John-Coding-c/ESP32-C3-WROOM-02-H4/docs/schematics/ESP32IoT-schematic.pdf

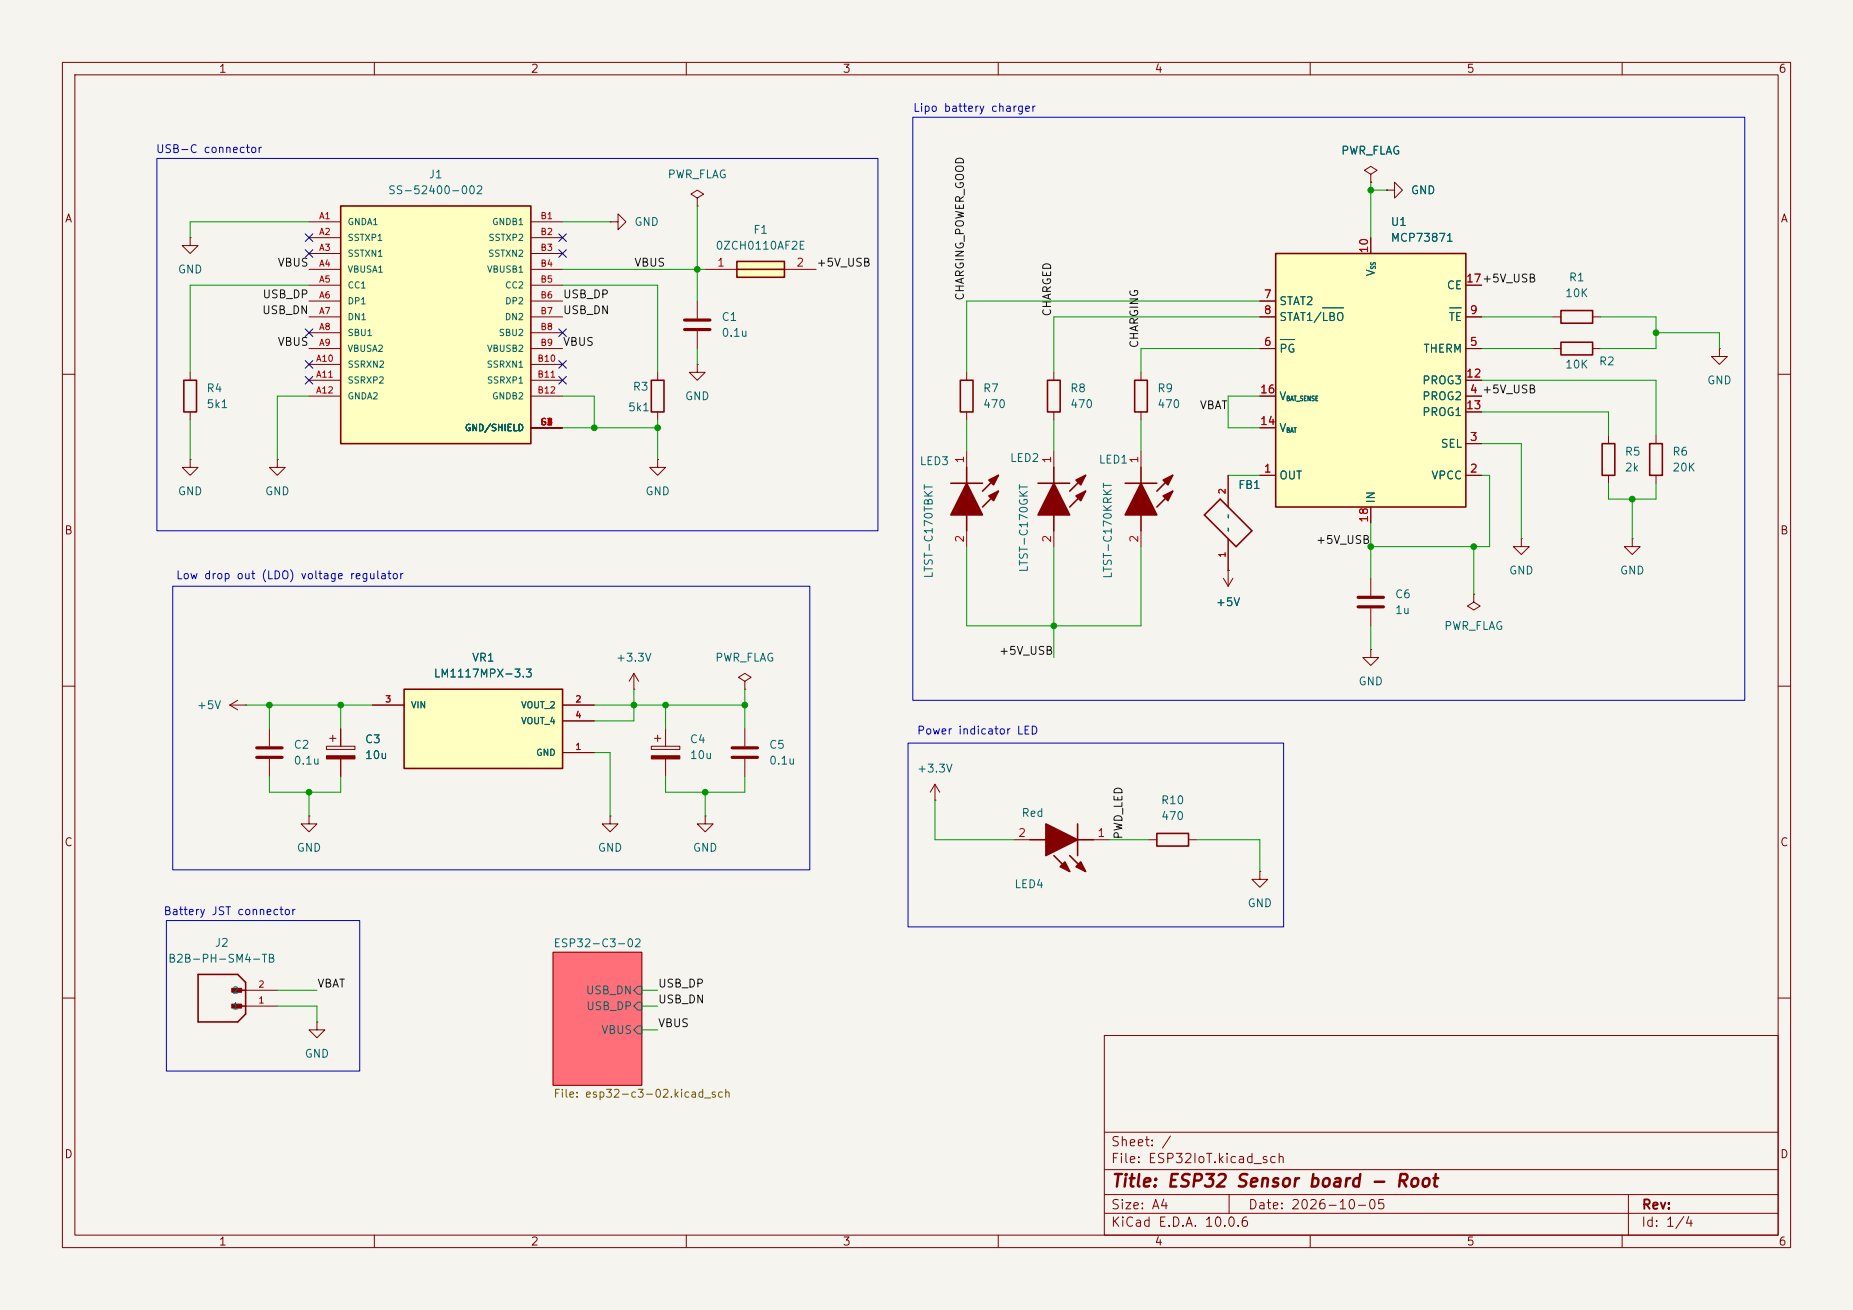
[picture p8: page 1]

Lipo battery charger Low drop out (LDO) voltage regulator

Sheet: /
File: ESP32IoT.kicad_sch
Title: ESP32 Sensor board - Root

Size: A4 | Rev:
KiCad E.D.A. 10.0.6 | Id: 1/4

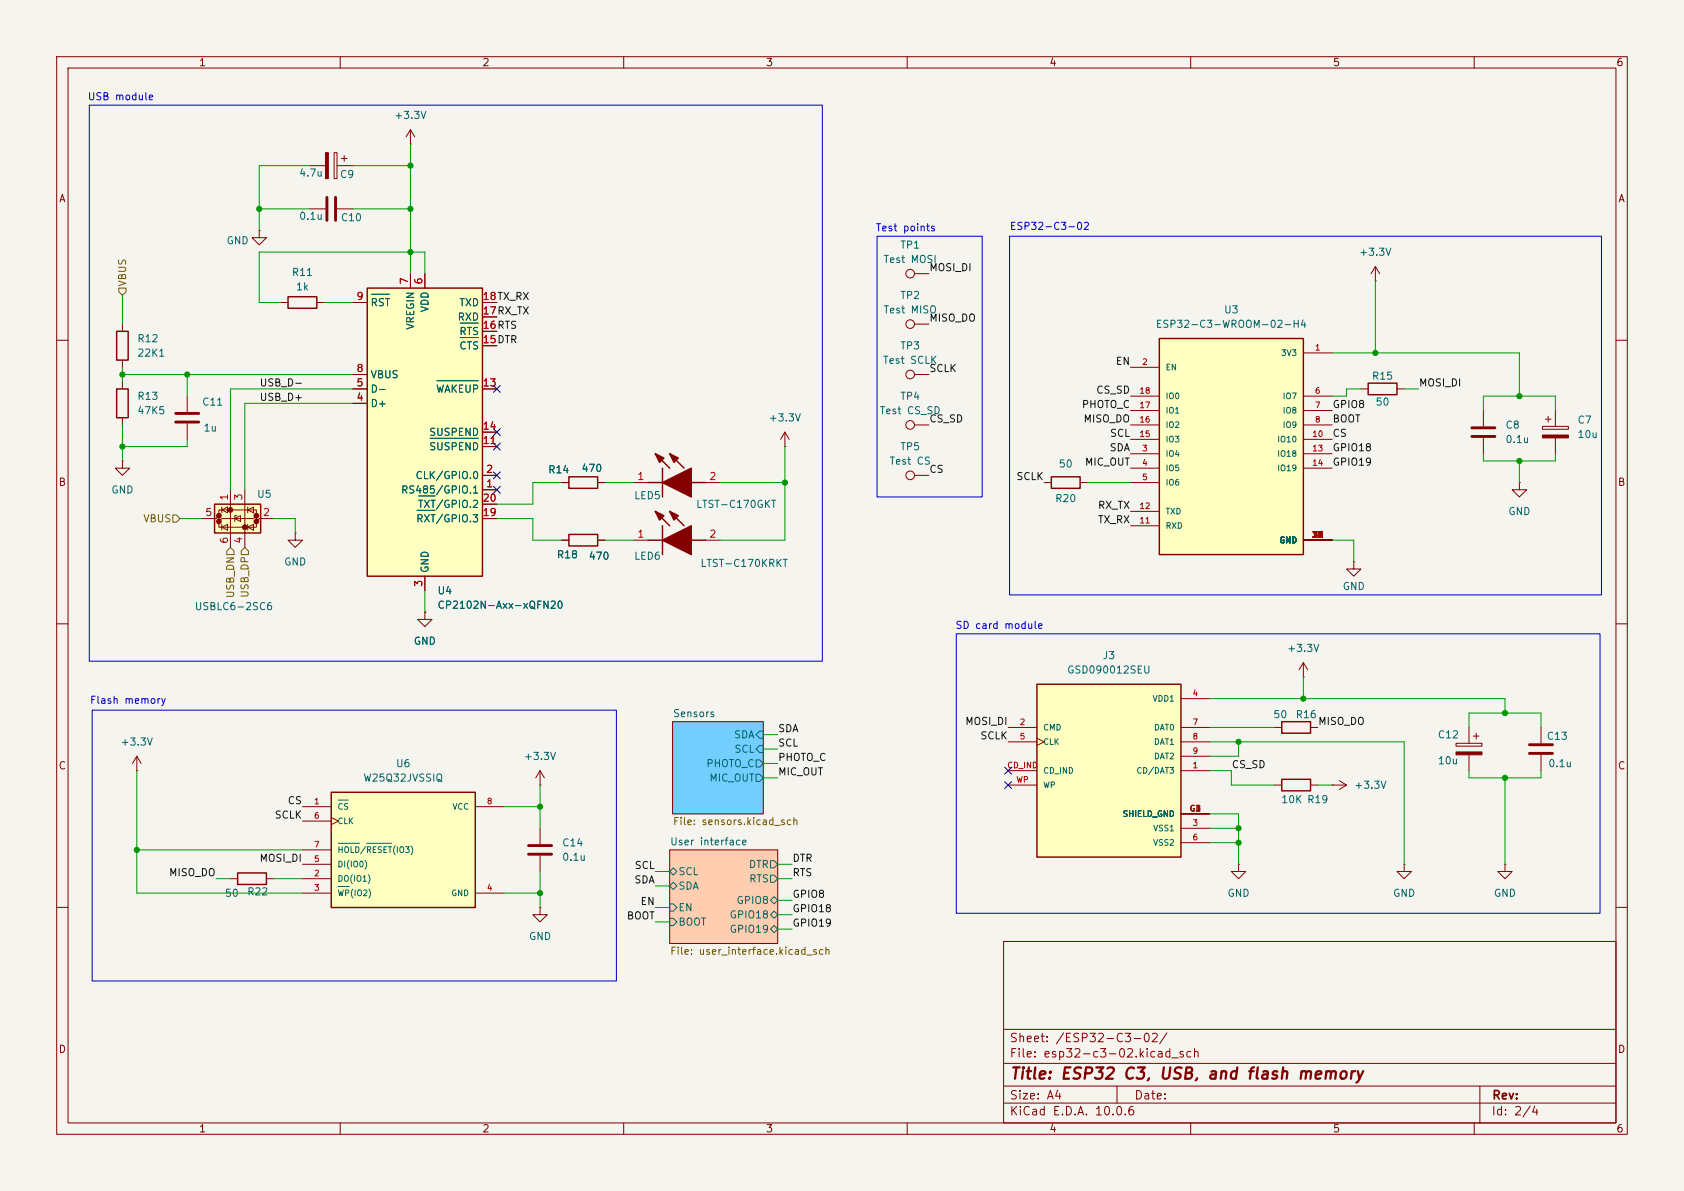
[picture p9: page 2]

SUSPEND 14 CTS 15 RTS 16 RXD 17 TXD 18 RXT/GPIO.3 19 TXT/GPIO.2 20 U4CP2102N-Axx-xQFN20

SCL SDA Sensors File: sensors.kicad_sch

Sheet: /ESP32-C3-02/
File: esp32-c3-02.kicad_sch
Title: ESP32 C3, USB, and flash memory

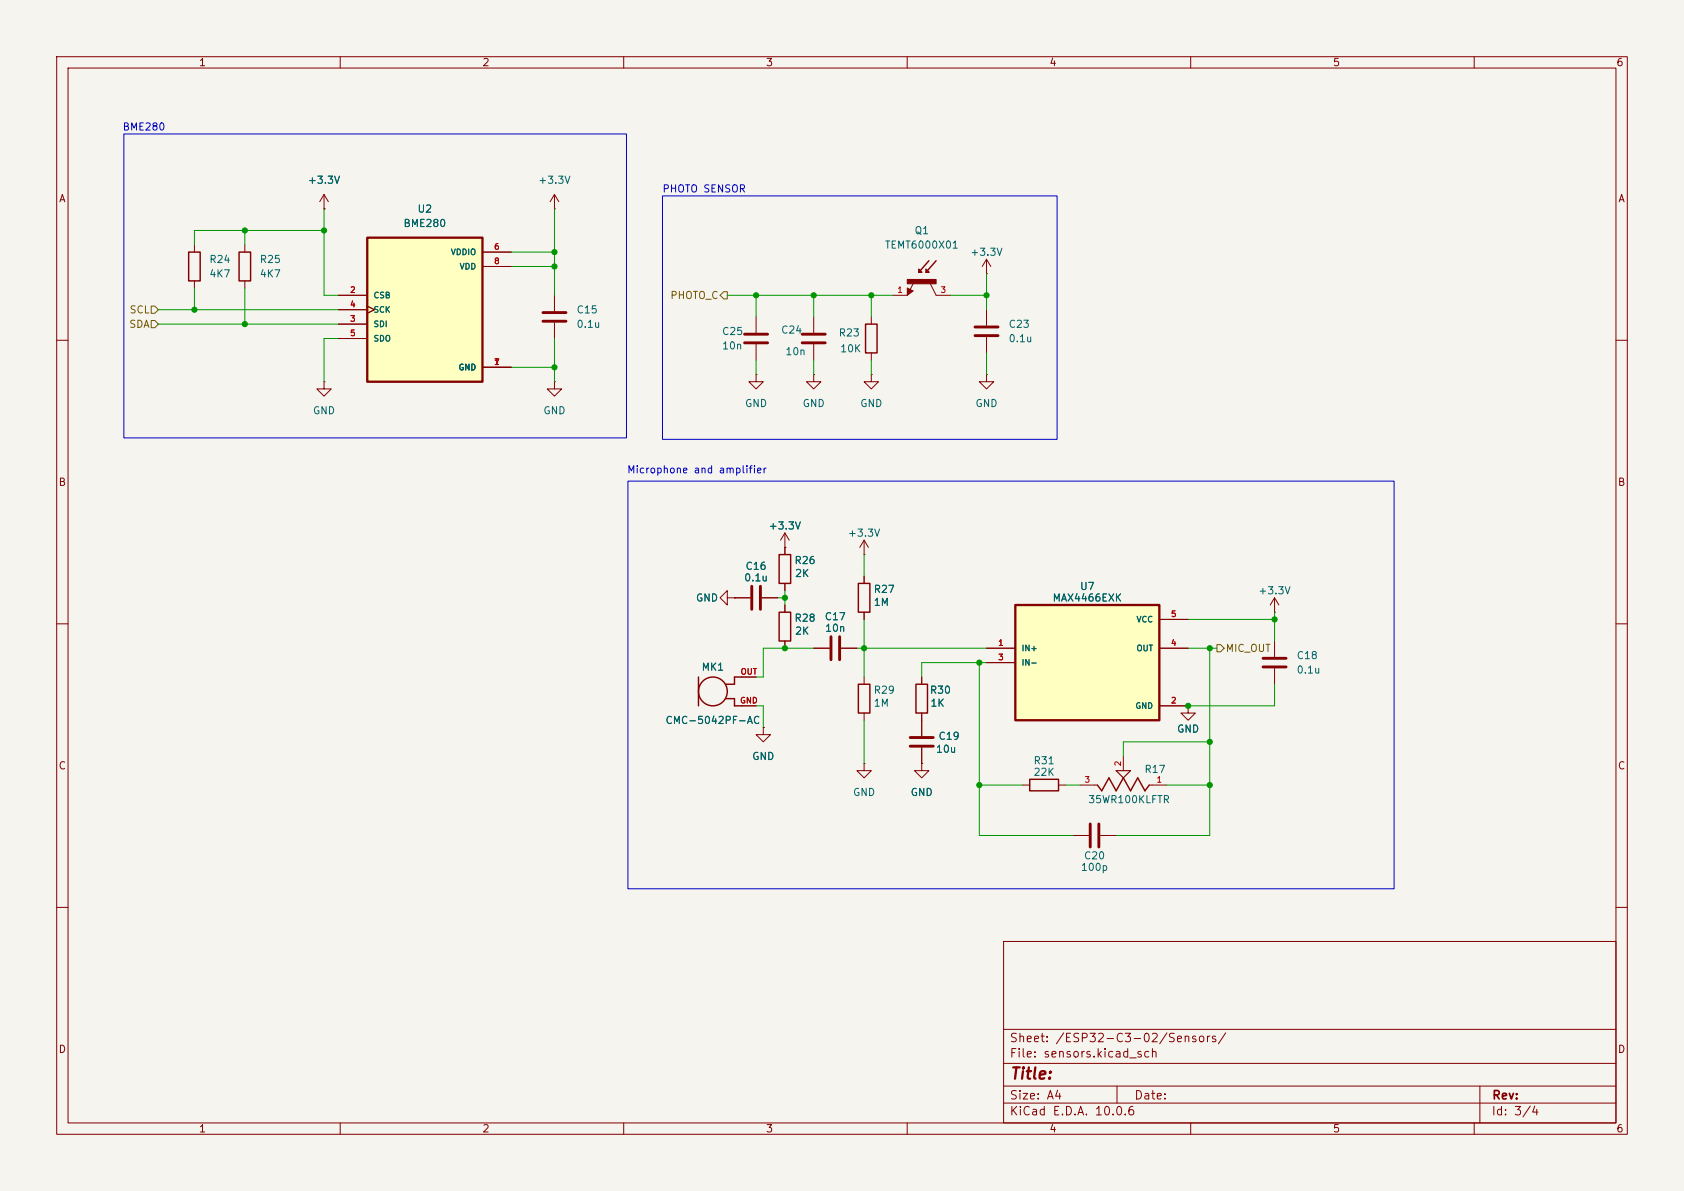
[picture p10: page 3]

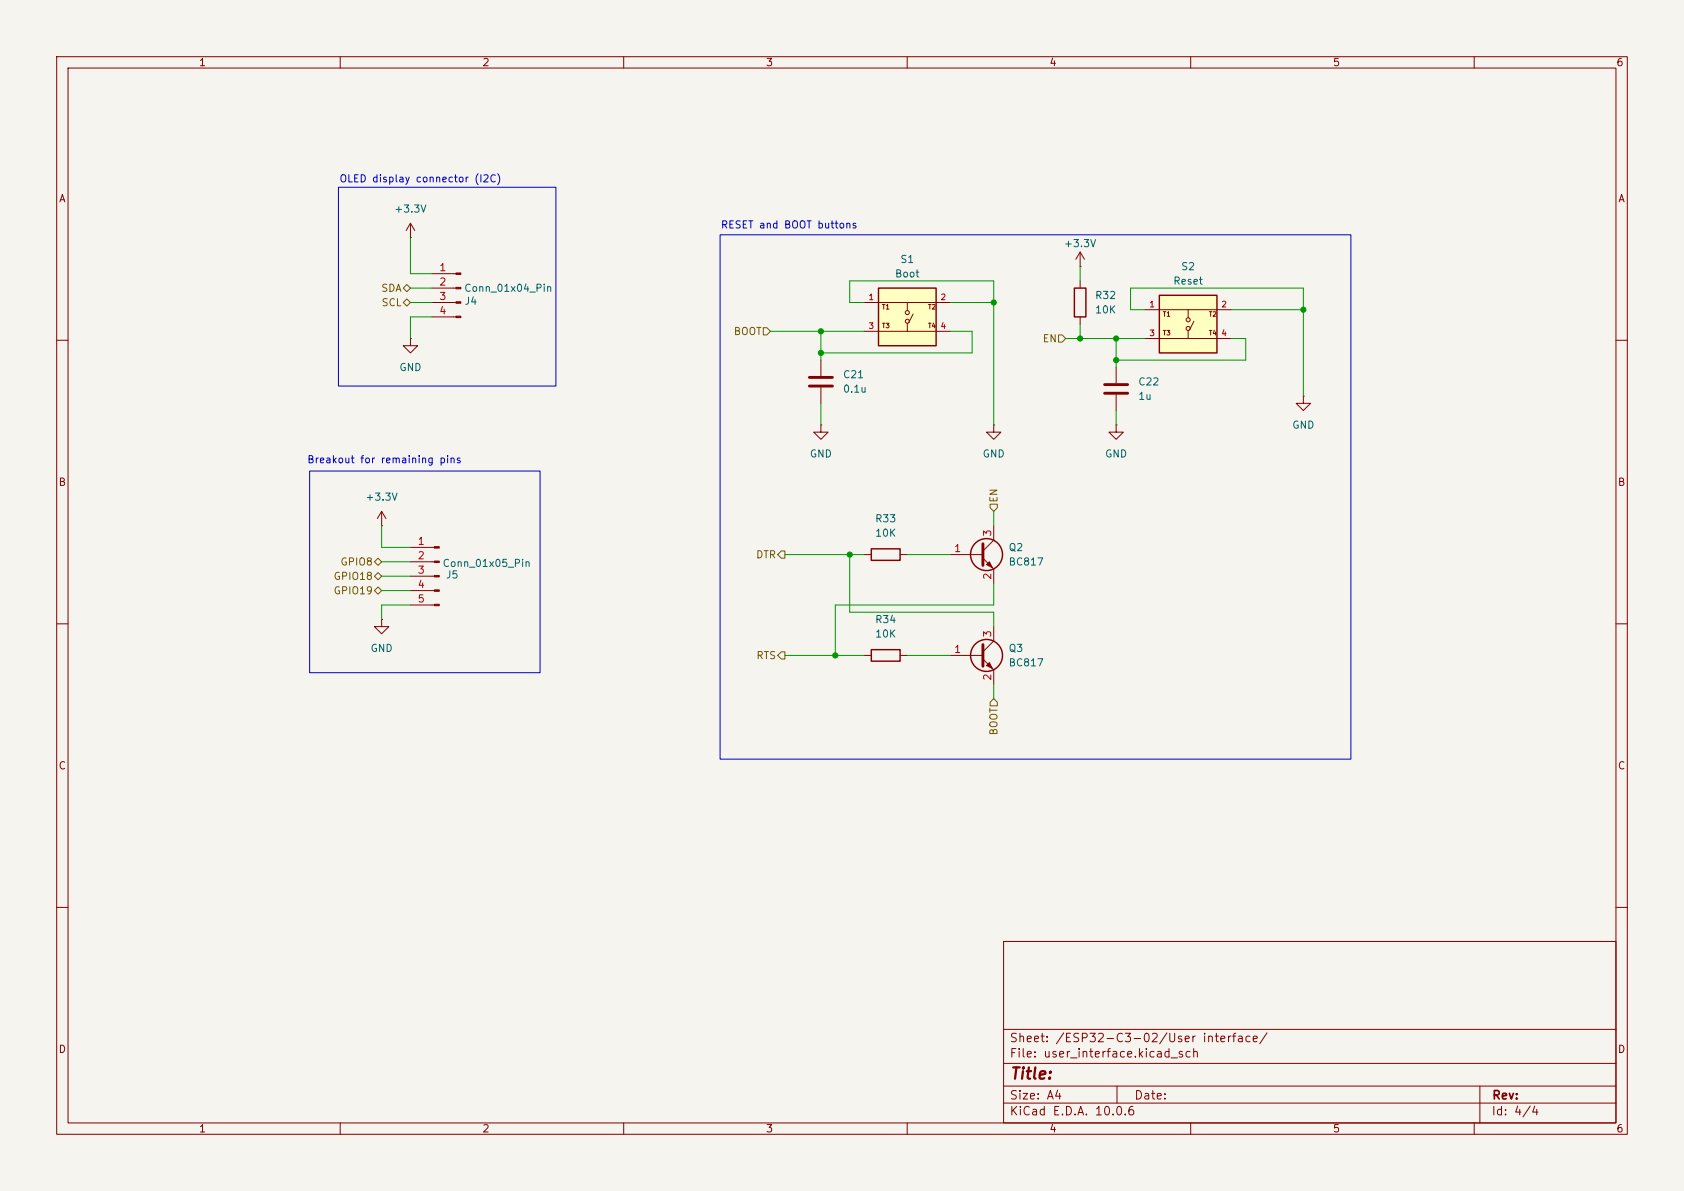
[picture p11: page 4]
