John-Coding-c/ESP32-C3-WROOM-02-H4/ESP32IoT.kicad_pcb

## KiCad design ESP32IoT.kicad_pcb (2026-10-12)

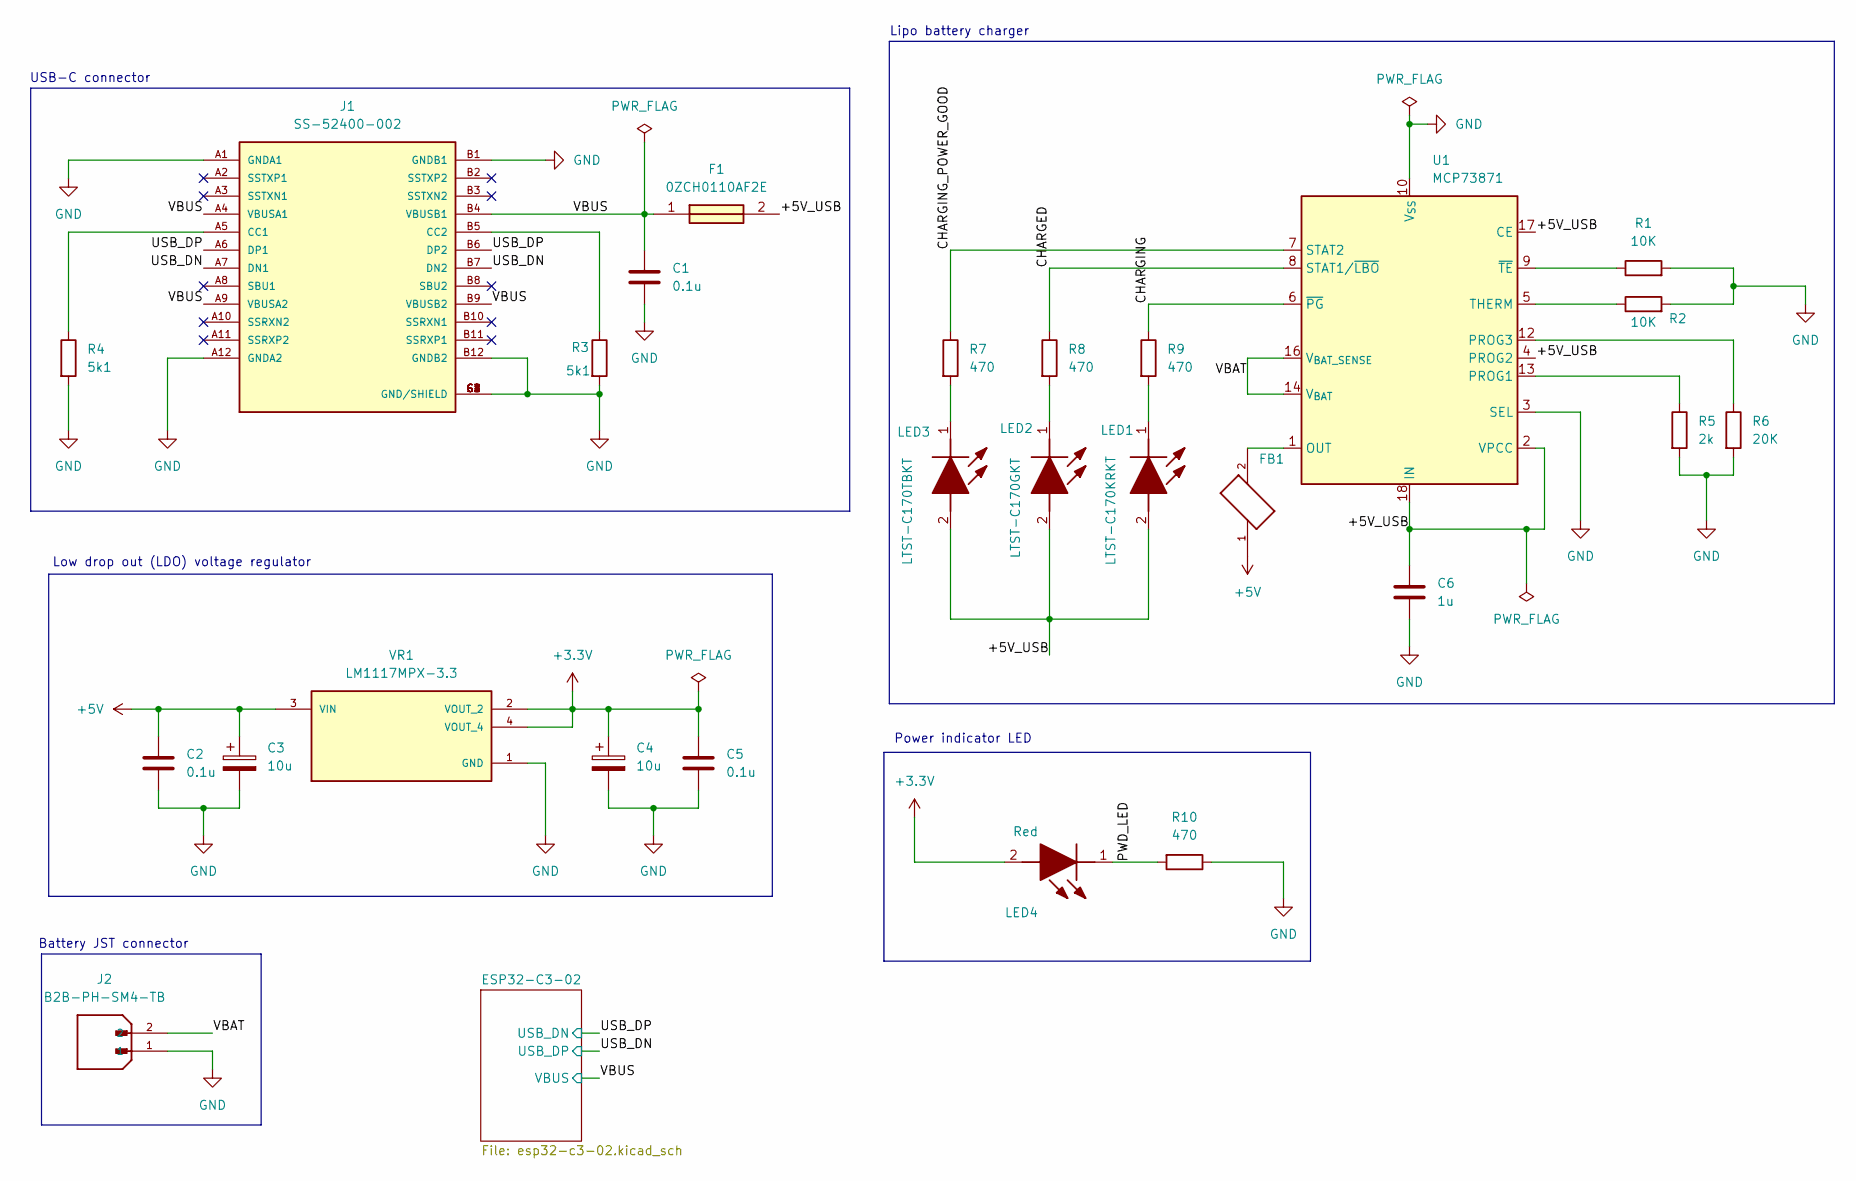
[picture p12: schematic ESP32IoT.kicad_sch, ESP32 Sensor board - Root]

Parts:
C1, C2, C5: 0.1u; C_0805_2012Metric
C3, C4: 10u; T491A
C6: 1u; C_0805_2012Metric
F1: 0ZCH0110AF2E; FUSC3226X100N; Manufacturer_Part_Number 0ZCH0110AF2E
FB1: FBMJ2125HM330-T; BEADC2012X105N
J1: SS-52400-002; BELFUSE_SS-52400-002; PARTREV A0
J2: B2B-PH-SM4-TB; JST_B2B-PH-SM4-TB; PARTREV N/A
LED1: LTST-C170KRKT; LEDC2012X120N; Manufacturer_Part_Number LTST-C170KRKT; Mouser Part Number 859-LTST-C170KRKT
LED2: LTST-C170GKT; LEDC2012X120N; Manufacturer_Part_Number LTST-C170GKT; Mouser Part Number 859-LTST-C170GKT
LED3: LTST-C170TBKT; LEDC2012X120N; Manufacturer_Part_Number LTST-C170TBKT; Mouser Part Number 859-LTST-C170TBKT
LED4: Red; LEDC2012X120N; Manufacturer_Part_Number LTST-C170KRKT; Mouser Part Number 859-LTST-C170KRKT
R1, R2: 10K; R_0805_2012Metric
R3, R4: 5k1; R_0805_2012Metric
R5: 2k; R_0805_2012Metric
R6: 20K; R_0805_2012Metric
R7, R8, R9, R10: 470; R_0805_2012Metric
U1: MCP73871; QFN-20-1EP_4x4mm_P0.5mm_EP2.5x2.5mm
VR1: LM1117MPX-3.3; VREG_LM1117MPX-3.3

Connections:
+3.3V: C4.1, C5.1, LED4.2 (A), VR1.2 (VOUT_2), VR1.4 (VOUT_4); also elsewhere on the board
+5V: C2.1, C3.1, FB1.1, VR1.3 (VIN)
/+5V_USB: C6.1, F1.2, LED1.2 (A), LED2.2 (A), LED3.2 (A), U1.2 (VPCC), U1.4 (PROG2), U1.17 (CE), U1.18 (IN), U1.19 (IN)
/CHARGED: R8.1, U1.8 (STAT1/~LBO)
/CHARGING: R9.1, U1.6 (~PG)
/CHARGING_POWER_GOOD: R7.1, U1.7 (STAT2)
/PWD_LED: LED4.1 (K), R10.2
/USB_DN: J1.A7 (DN1), J1.B7 (DN2); also elsewhere on the board
/USB_DP: J1.A6 (DP1), J1.B6 (DP2); also elsewhere on the board
/VBAT: J2.2, U1.14 (V_{BAT}), U1.15 (V_{BAT}), U1.16 (V_{BAT_SENSE})
/VBUS: C1.1, F1.1, J1.A4 (VBUSA1), J1.A9 (VBUSA2), J1.B4 (VBUSB1), J1.B9 (VBUSB2); also elsewhere on the board
GND: C1.2, C2.2, C3.2, C4.2, C5.2, C6.2, J1.A1 (GNDA1), J1.A12 (GNDA2), J1.B1 (GNDB1), J1.B12 (GNDB2), J1.G1 (GND/SHIELD), J1.G2 (GND/SHIELD), J1.G3 (GND/SHIELD), J1.G4 (GND/SHIELD), J1.S1 (GND/SHIELD), J1.S2 (GND/SHIELD), J1.S3 (GND/SHIELD), J1.S4 (GND/SHIELD), J2.1, R1.2, R2.2, R3.2, R4.2, R5.2, R6.2, R10.1, U1.3 (SEL), U1.10 (V_{SS}), U1.11 (V_{SS}), U1.21 (V_{SS}), VR1.1 (GND); also elsewhere on the board
unnamed: FB1.2, U1.1 (OUT), U1.20 (OUT)
unnamed: J1.A5 (CC1), R4.1
unnamed: J1.B5 (CC2), R3.1
unnamed: LED1.1 (K), R9.2
unnamed: LED2.1 (K), R8.2
unnamed: LED3.1 (K), R7.2
unnamed: R5.1, U1.13 (PROG1)
unnamed: R6.1, U1.12 (PROG3)
unnamed: R2.1, U1.5 (THERM)
unnamed: R1.1, U1.9 (~TE)

Notes on the sheet:
USB-C connector
Power indicator LED
Lipo battery charger
Battery JST connector
Low drop out (LDO) voltage regulator

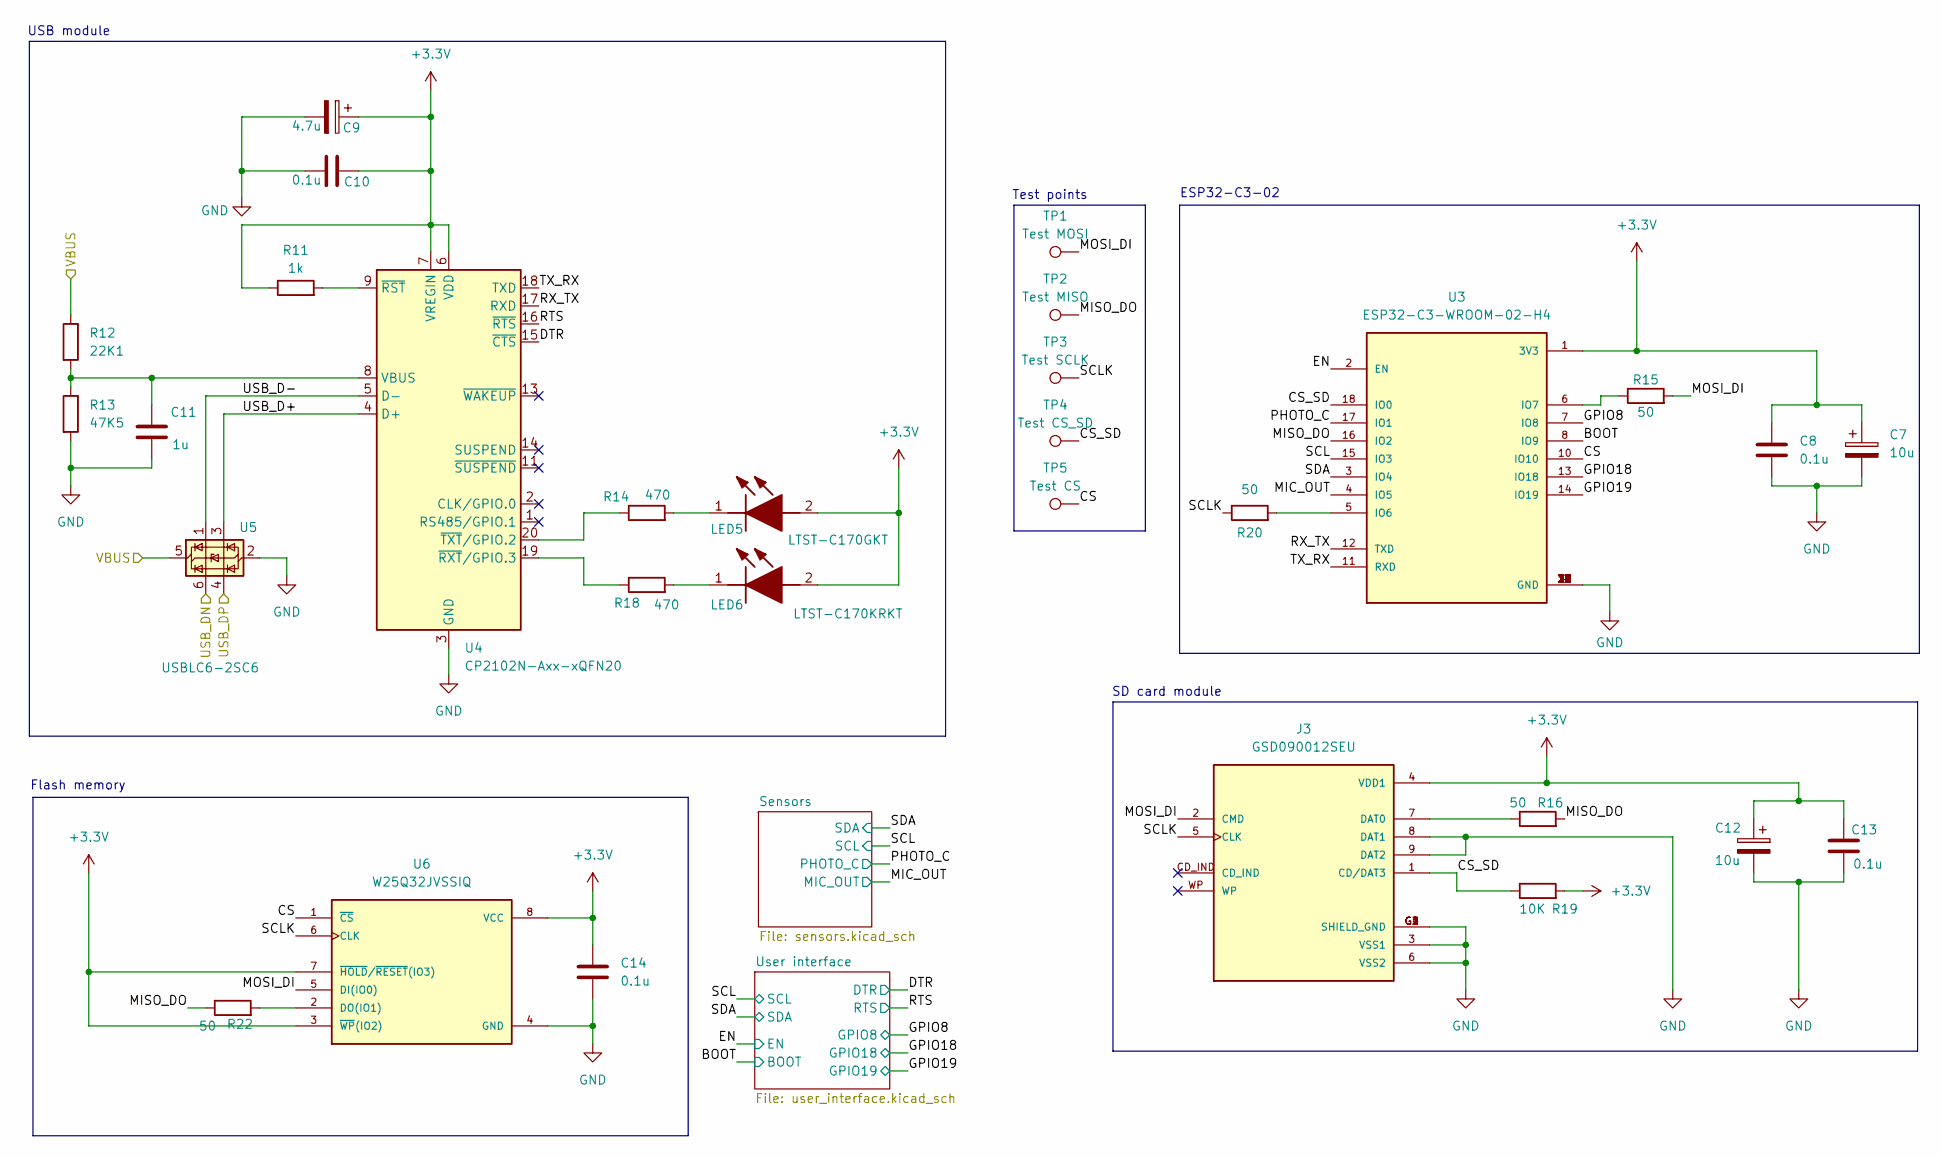
[picture p13: schematic esp32-c3-02.kicad_sch, ESP32 C3, USB, and flash memory]

Parts:
C7, C12: 10u; T491A
C8, C10, C13, C14: 0.1u; C_0805_2012Metric
C9: 4.7u; T491A
C11: 1u; C_0805_2012Metric
J3: GSD090012SEU; AMPHENOL_GSD090012SEU; PARTREV E
LED5: LTST-C170GKT; LEDC2012X120N; Manufacturer_Part_Number LTST-C170GKT; Mouser Part Number 859-LTST-C170GKT
LED6: LTST-C170KRKT; LEDC2012X120N; Manufacturer_Part_Number LTST-C170KRKT; Mouser Part Number 859-LTST-C170KRKT
R11: 1k; R_0805_2012Metric
R12: 22K1; R_0805_2012Metric
R13: 47K5; R_0805_2012Metric
R14, R18: 470; R_0805_2012Metric
R15, R16, R20, R22: 50; R_0805_2012Metric
R19: 10K; R_0805_2012Metric
TP1: Test MOSI; TestPoint_Pad_D1.0mm
TP2: Test MISO; TestPoint_Pad_D1.0mm
TP3: Test SCLK; TestPoint_Pad_D1.0mm
TP4: Test CS_SD; TestPoint_Pad_D1.0mm
TP5: Test CS; TestPoint_Pad_D1.0mm
U3: ESP32-C3-WROOM-02-H4; MODULE_ESP32-C3-WROOM-02-H4
U4: CP2102N-Axx-xQFN20; SiliconLabs_QFN-20-1EP_3x3mm_P0.5mm_EP1.8x1.8mm
U5: USBLC6-2SC6; SOT-23-6
U6: W25Q32JVSSIQ; SOIC127P790X216-8N; M_PART_NUMBER W25QXX

Connections:
+3.3V: C7.1, C8.1, C9.1, C10.2, C12.1, C13.1, C14.1, J3.4 (VDD1), LED5.2 (A), LED6.2 (A), R11.1, R19.2, U3.1 (3V3), U4.6 (VDD), U4.7 (VREGIN), U6.3 (~WP(IO2)), U6.7 (~HOLD/~RESET(IO3)), U6.8 (VCC); also elsewhere on the board
/ESP32-C3-02/BOOT: U3.8 (IO9); also elsewhere on the board
/ESP32-C3-02/CS: TP5.1 (1_1), U3.10 (IO10), U6.1 (~CS)
/ESP32-C3-02/CS_SD: J3.1 (CD/DAT3), R19.1, TP4.1 (1_1), U3.18 (IO0)
/ESP32-C3-02/DTR: U4.15 (~CTS); also elsewhere on the board
/ESP32-C3-02/EN: U3.2 (EN); also elsewhere on the board
/ESP32-C3-02/GPIO8: U3.7 (IO8); also elsewhere on the board
/ESP32-C3-02/GPIO18: U3.13 (IO18); also elsewhere on the board
/ESP32-C3-02/GPIO19: U3.14 (IO19); also elsewhere on the board
/ESP32-C3-02/MIC_OUT: U3.4 (IO5); also elsewhere on the board
/ESP32-C3-02/MISO_DO: R16.2, R22.1, TP2.1 (1_1), U3.16 (IO2)
/ESP32-C3-02/MOSI_DI: J3.2 (CMD), R15.2, TP1.1 (1_1), U6.5 (DI(IO0))
/ESP32-C3-02/PHOTO_C: U3.17 (IO1); also elsewhere on the board
/ESP32-C3-02/RTS: U4.16 (~RTS); also elsewhere on the board
/ESP32-C3-02/RX_TX: U3.12 (TXD), U4.17 (RXD)
/ESP32-C3-02/SCL: U3.15 (IO3); also elsewhere on the board
/ESP32-C3-02/SCLK: J3.5 (CLK), R20.1, TP3.1 (1_1), U6.6 (CLK)
/ESP32-C3-02/SDA: U3.3 (IO4); also elsewhere on the board
/ESP32-C3-02/TX_RX: U3.11 (RXD), U4.18 (TXD)
/ESP32-C3-02/USB_D+: U4.4 (D+), U5.3 (I/O2)
/ESP32-C3-02/USB_D-: U4.5 (D-), U5.1 (I/O1)
/USB_DN: U5.4 (I/O2); also elsewhere on the board
/USB_DP: U5.6 (I/O1); also elsewhere on the board
/VBUS: R12.1, U5.5 (VBUS); also elsewhere on the board
GND: C7.2, C8.2, C9.2, C10.1, C11.2, C12.2, C13.2, C14.2, J3.3 (VSS1), J3.6 (VSS2), J3.8 (DAT1), J3.9 (DAT2), J3.G1 (SHIELD_GND), J3.G2 (SHIELD_GND), J3.G3 (SHIELD_GND), J3.G4 (SHIELD_GND), R13.2, U3.9 (GND), U3.19 (GND), U3.20 (GND), U3.21 (GND), U3.22 (GND), U3.23 (GND), U3.24 (GND), U3.25 (GND), U3.26 (GND), U3.27 (GND), U3.28 (GND), U3.29 (GND), U3.30 (GND), U3.31 (GND), U3.32 (GND), U3.33 (GND), U3.34 (GND), U3.35 (GND), U3.36 (GND), U3.37 (GND), U3.38 (GND), U3.39 (GND), U4.3 (GND), U4.12 (GND), U4.21 (GND), U5.2 (GND), U6.4 (GND); also elsewhere on the board
unnamed: J3.7 (DAT0), R16.1
unnamed: LED5.1 (K), R14.2
unnamed: LED6.1 (K), R18.2
unnamed: R20.2, U3.5 (IO6)
unnamed: R15.1, U3.6 (IO7)
unnamed: C11.1, R12.2, R13.1, U4.8 (VBUS)
unnamed: R11.2, U4.9 (~RST)
unnamed: R18.1, U4.19 (~RXT/GPIO.3)
unnamed: R14.1, U4.20 (~TXT/GPIO.2)
unnamed: R22.2, U6.2 (DO(IO1))

Notes on the sheet:
SD card module
Flash memory
Test points
ESP32-C3-02
USB module

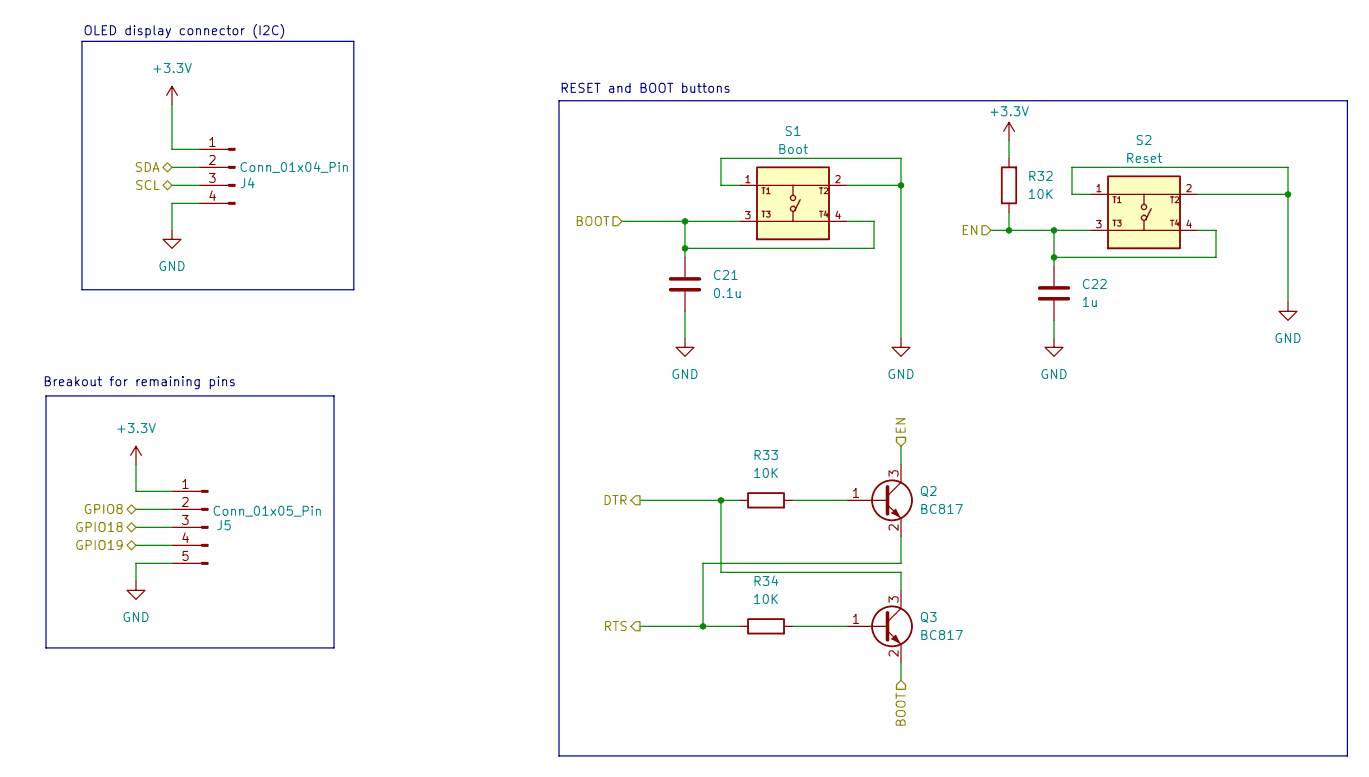
[picture p14: schematic user_interface.kicad_sch]

Parts:
C21: 0.1u; C_0805_2012Metric
C22: 1u; C_0805_2012Metric
J4: Conn_01x04_Pin; PinHeader_1x04_P2.54mm_Vertical
J5: Conn_01x05_Pin; PinHeader_1x05_P2.54mm_Vertical
Q2, Q3: BC817; SOT-23
R32, R33, R34: 10K; R_0805_2012Metric
S1: Boot; SW_USLPT2819DT2TR; PARTREV P
S2: Reset; SW_USLPT2819DT2TR; PARTREV P

Connections:
+3.3V: J4.1, J5.1, R32.2; also elsewhere on the board
/ESP32-C3-02/BOOT: C21.1, Q3.2 (E), S1.3, S1.4; also elsewhere on the board
/ESP32-C3-02/DTR: Q3.3 (C), R33.1; also elsewhere on the board
/ESP32-C3-02/EN: C22.1, Q2.3 (C), R32.1, S2.3, S2.4; also elsewhere on the board
/ESP32-C3-02/GPIO8: J5.2; also elsewhere on the board
/ESP32-C3-02/GPIO18: J5.3; also elsewhere on the board
/ESP32-C3-02/GPIO19: J5.4; also elsewhere on the board
/ESP32-C3-02/RTS: Q2.2 (E), R34.1; also elsewhere on the board
/ESP32-C3-02/SCL: J4.3; also elsewhere on the board
/ESP32-C3-02/SDA: J4.2; also elsewhere on the board
GND: C21.2, C22.2, J4.4, J5.5, S1.1, S1.2, S2.1, S2.2; also elsewhere on the board
unnamed: Q2.1 (B), R33.2
unnamed: Q3.1 (B), R34.2

Notes on the sheet:
OLED display connector (I2C)
RESET and BOOT buttons
Breakout for remaining pins

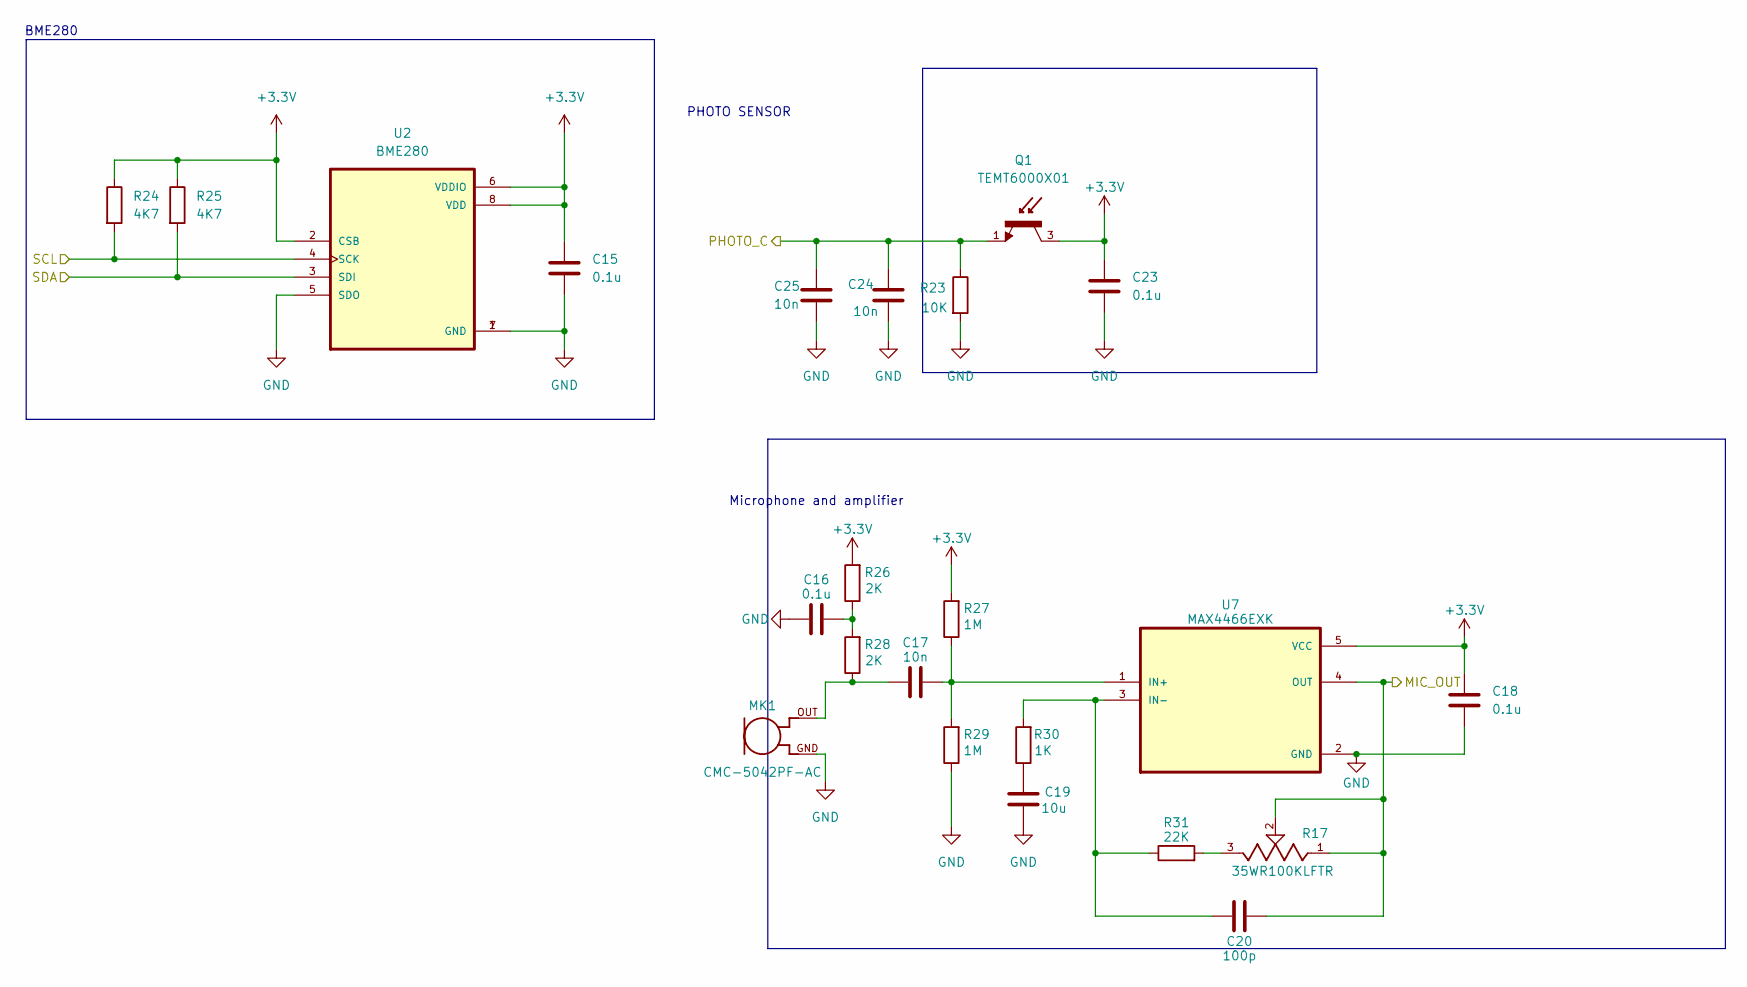
[picture p15: schematic sensors.kicad_sch]

Parts:
C15, C16, C18, C23: 0.1u; C_0805_2012Metric
C17, C24, C25: 10n; C_0805_2012Metric
C19: 10u; C_0805_2012Metric
C20: 100p; C_0805_2012Metric
MK1: CMC-5042PF-AC; CUI_CMC-5042PF-AC; Manufacturer_Part_Number CMC-5042PF-AC
Q1: TEMT6000X01; TRANS_TEMT6000X01; PARTREV 1.9
R17: 35WR100KLFTR; TRIM_35WR100KLFTR; PARTREV D
R23: 10K; R_0805_2012Metric
R24, R25: 4K7; R_0805_2012Metric
R26, R28: 2K; R_0805_2012Metric
R27, R29: 1M; R_0805_2012Metric
R30: 1K; R_0805_2012Metric
R31: 22K; R_0805_2012Metric
U2: BME280; PSON65P250X250X100-8N
U7: MAX4466EXK; SOT65P210X110-5N; Manufacturer_Part_Number MAX4466EXK

Connections:
+3.3V: C15.1, C18.1, C23.1, Q1.3, R24.1, R25.1, R26.2, R27.2, U2.2 (CSB), U2.6 (VDDIO), U2.8 (VDD), U7.5 (VCC); also elsewhere on the board
/ESP32-C3-02/MIC_OUT: C20.2, R17.1, R17.2, U7.4 (OUT); also elsewhere on the board
/ESP32-C3-02/PHOTO_C: C24.1, C25.1, Q1.1, R23.1; also elsewhere on the board
/ESP32-C3-02/SCL: R24.2, U2.4 (SCK); also elsewhere on the board
/ESP32-C3-02/SDA: R25.2, U2.3 (SDI); also elsewhere on the board
GND: C15.2, C16.2, C18.2, C19.1, C23.2, C24.2, C25.2, MK1.GND, R23.2, R29.1, U2.1 (GND), U2.5 (SDO), U2.7 (GND), U7.2 (GND); also elsewhere on the board
unnamed: C16.1, R26.1, R28.2
unnamed: C17.2, MK1.OUT, R28.1
unnamed: C19.2, R30.1
unnamed: R17.3, R31.2
unnamed: C17.1, R27.1, R29.2, U7.1 (IN+)
unnamed: C20.1, R30.2, R31.1, U7.3 (IN-)

Notes on the sheet:
BME280
PHOTO SENSOR
Microphone and amplifier

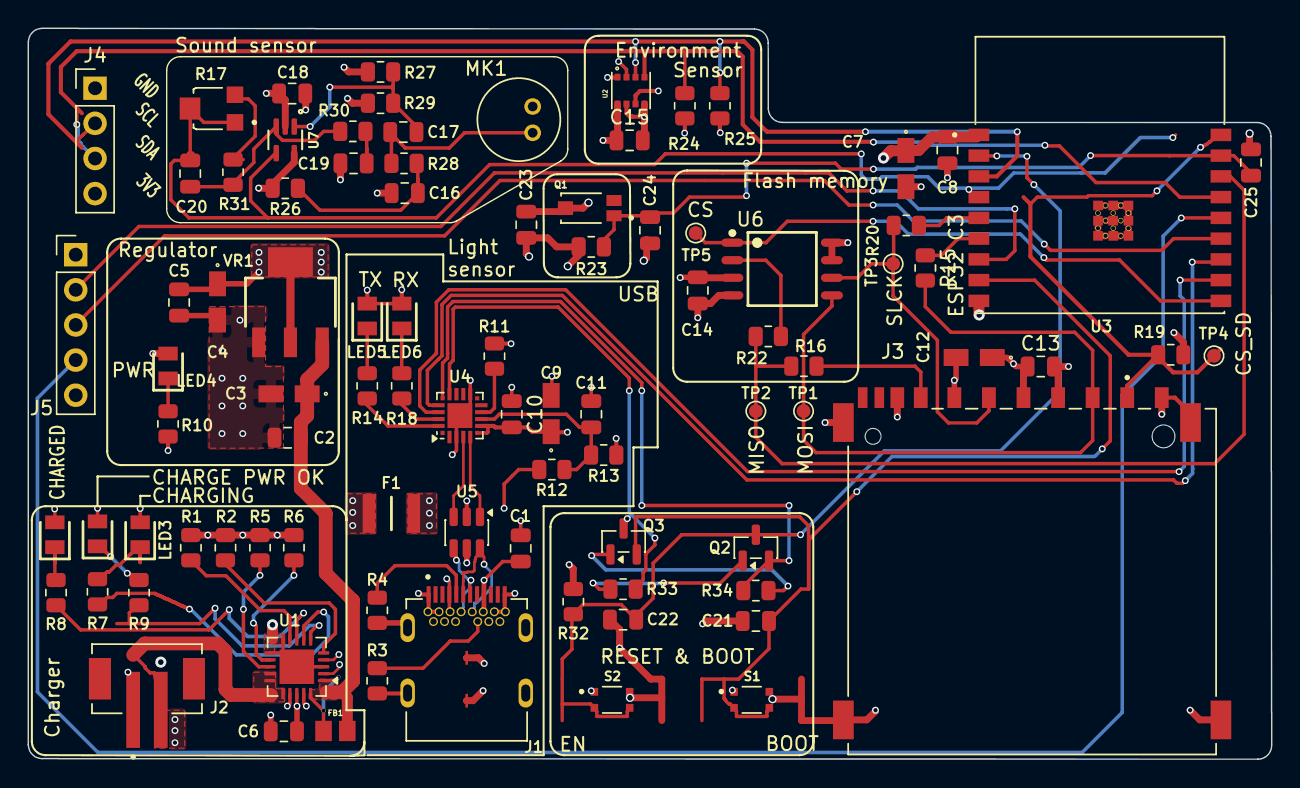
[picture p16: board ESP32IoT.kicad_pcb from above]

Board: 4 copper layers, 89.9 x 52.8 mm, 90 parts (0 on the bottom side), 60 nets.
